mdecycu/4072pj3/project3/40723102/image/40723102.jpg

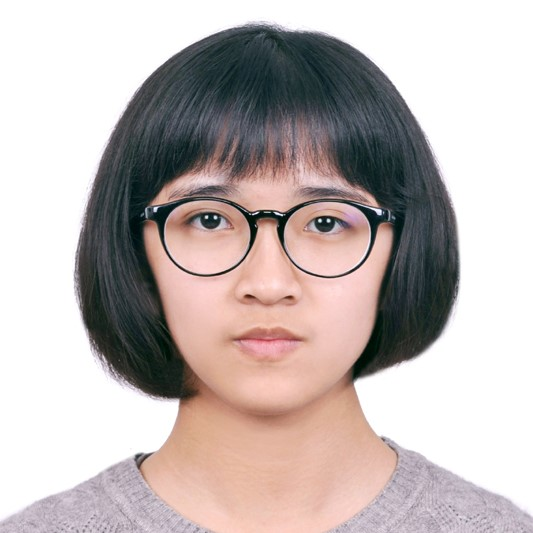
project3/40723102/image/40723102.jpg
