mdecycu/4072pj3/project3/40723102/image/40723103.jpg

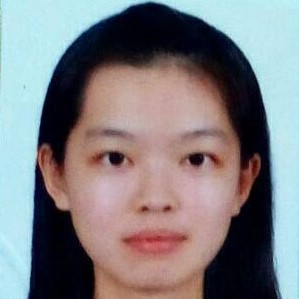
project3/40723102/image/40723103.jpg
