mdecycu/4072pj3/project3/40723102/latex/史蒂芬生機構第一型.PNG

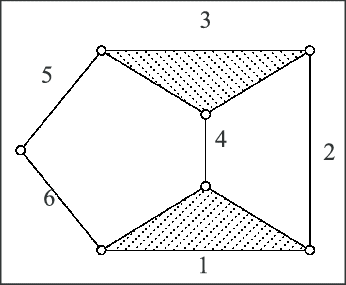
project3/40723102/latex/史蒂芬生機構第一型.PNG
