mdecycu/4072pj3/project3/40723153/架構圖S.png

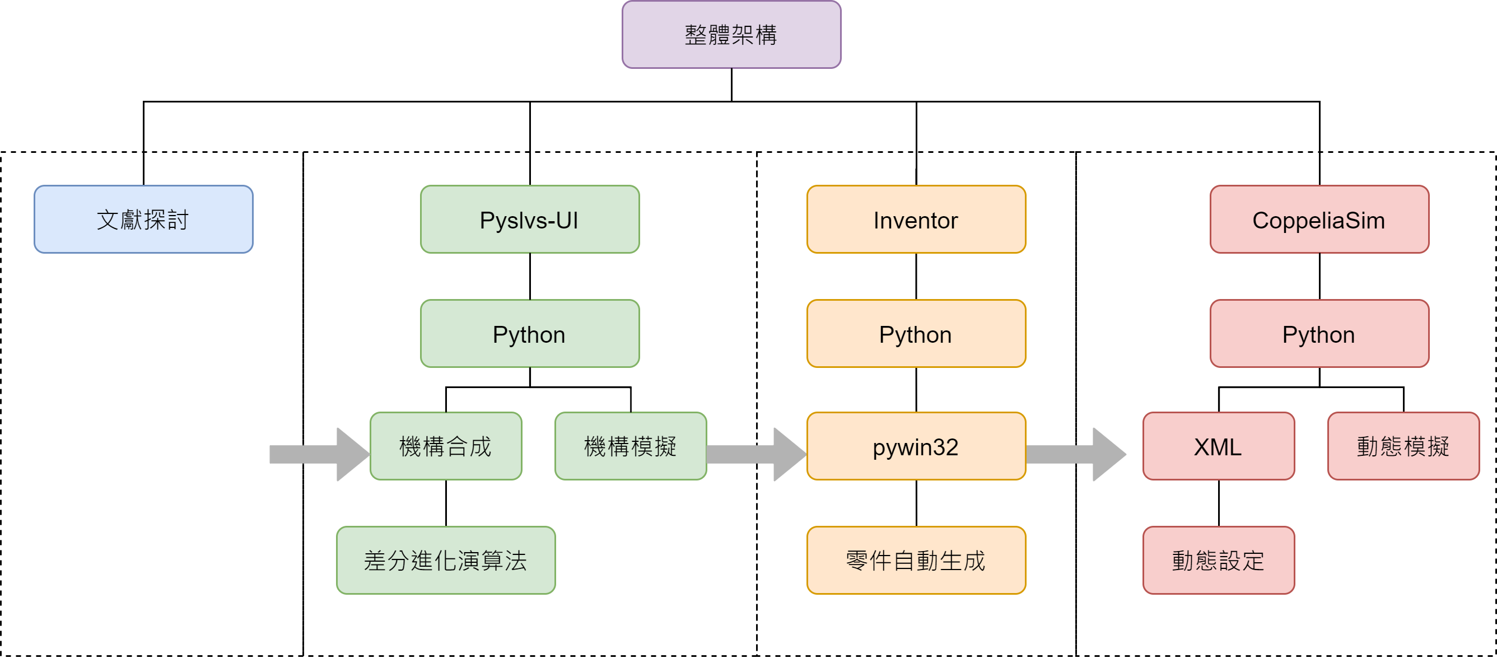
project3/40723153/架構圖S.png
