mdecycu/4072pj3/project3/latex/anti-rise_x-.png

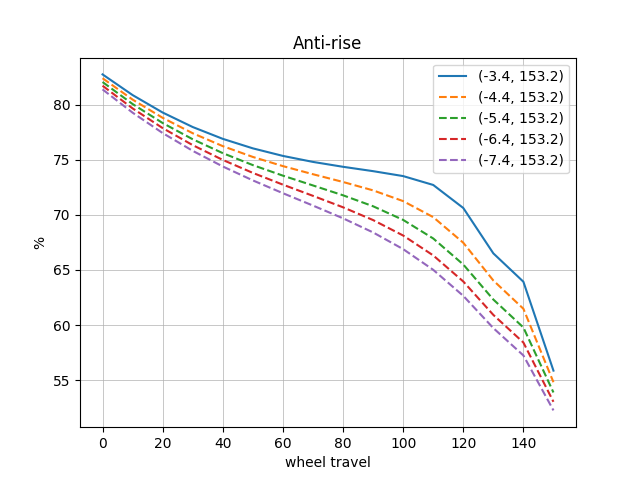
project3/latex/anti-rise_x-.png
