mdecycu/4072pj3/project3/latex/anti-squat_x-y+.png

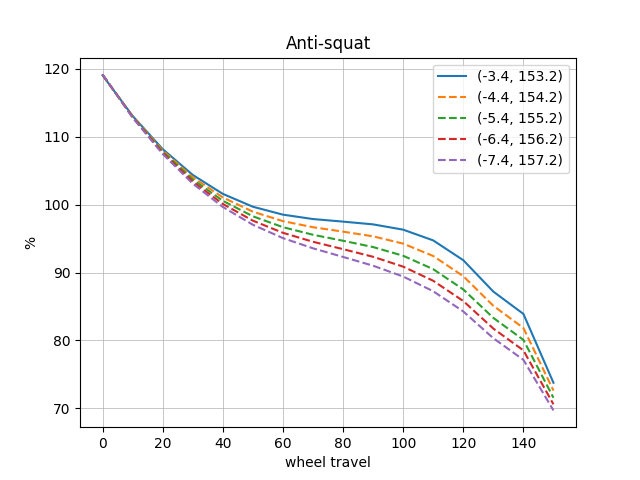
project3/latex/anti-squat_x-y+.png
