mdecycu/4072pj3/project3/latex/background2.png

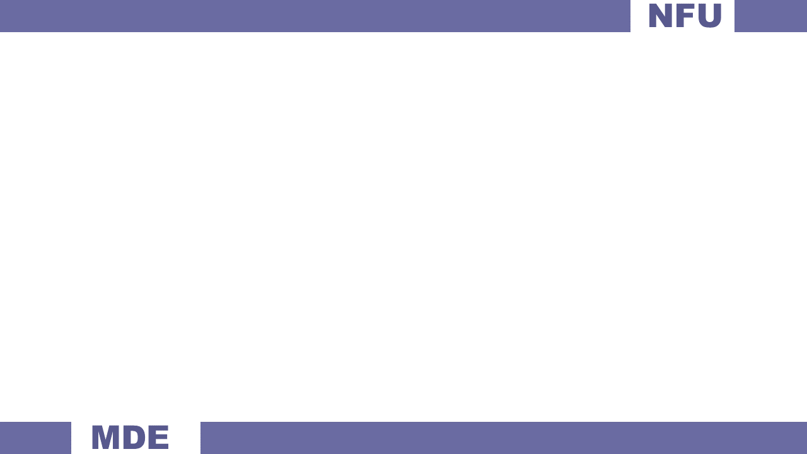
project3/latex/background2.png
