mdecycu/4072pj3/project3/latex/data/ar_p0_y+.png

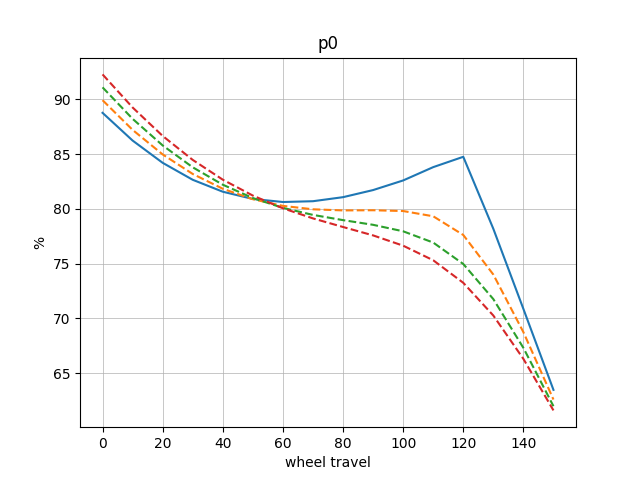
project3/latex/data/ar_p0_y+.png
