mdecycu/4072pj3/project3/latex/data/as_p0_x+.png

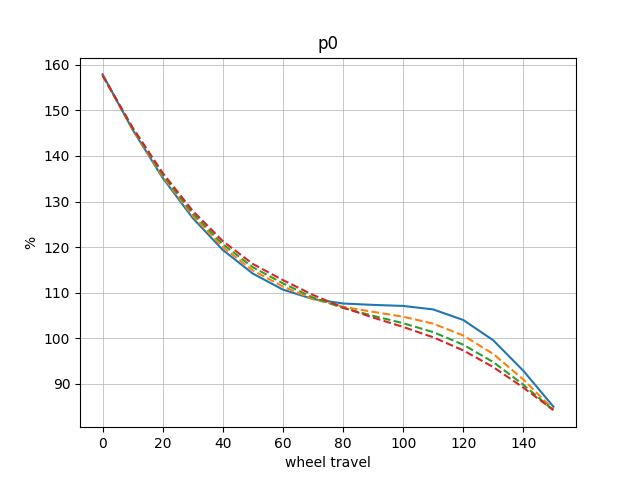
project3/latex/data/as_p0_x+.png
