mdecycu/4072pj3/project3/latex/data/as_p3_x+.png

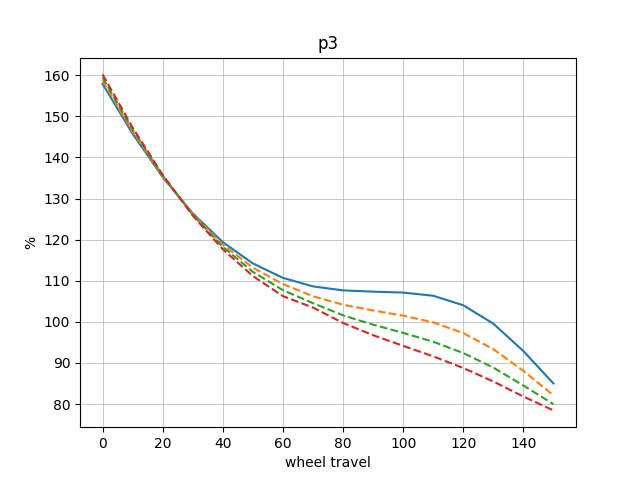
project3/latex/data/as_p3_x+.png
