mdecycu/4072pj3/project3/latex/machanism.png

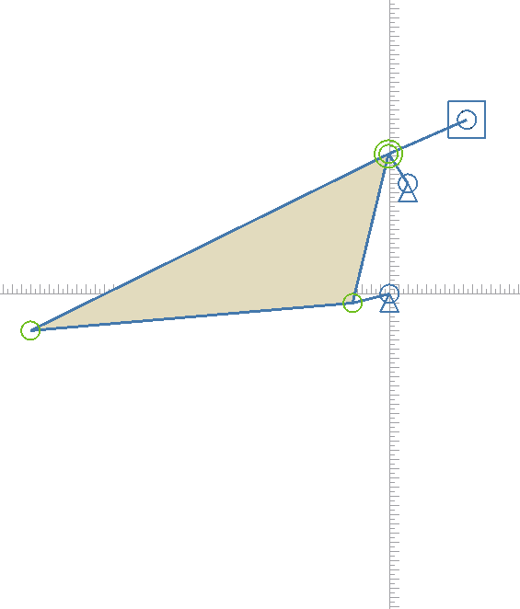
project3/latex/machanism.png
