mdecycu/4072pj3/project3/latex/wheel_travel.PNG

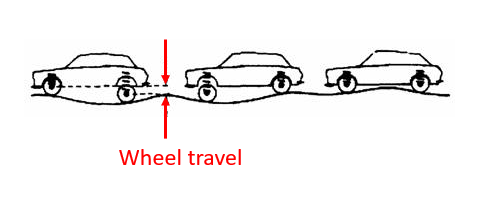
project3/latex/wheel_travel.PNG
