mdecycu/4072pj3/project3/latex/套件比較表格.jpg

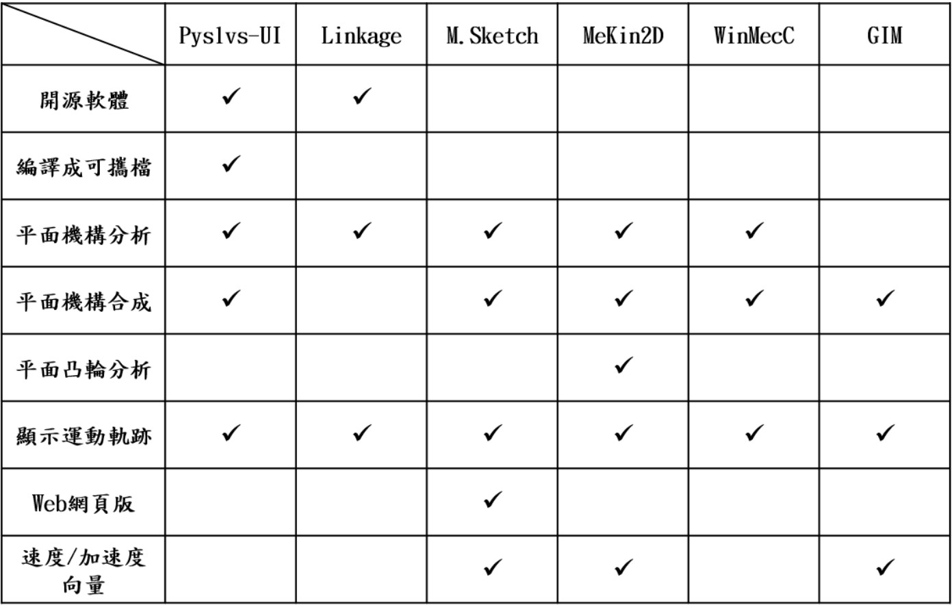
project3/latex/套件比較表格.jpg
