mdecycu/4072pj3/project3/latex/量化評比_anti_squat_x.png

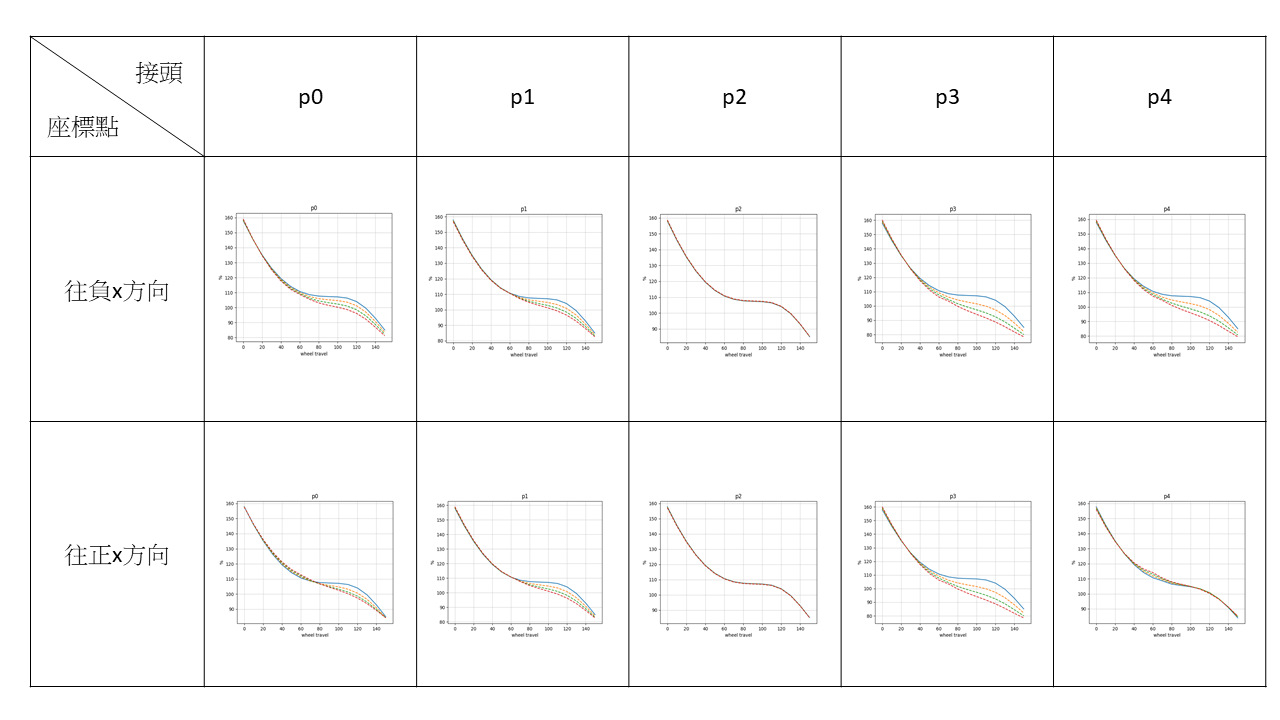
project3/latex/量化評比_anti_squat_x.png
