mdecycu/4072pj3/project3/40723245/bike_xml/Wheel.stl

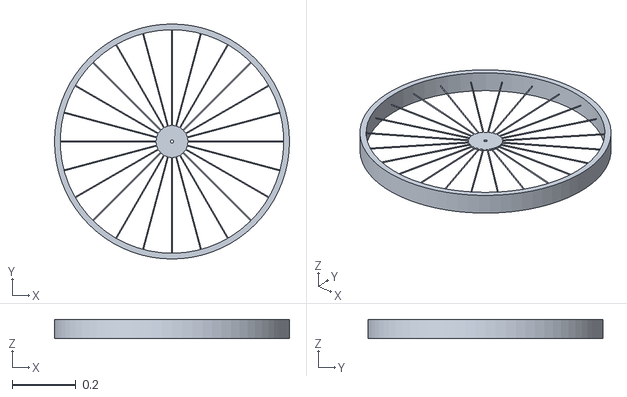
[picture p207: CAD file, 2021-05-03]
project3/40723245/bike_xml/Wheel.stl
0.736 x 0.736 x 0.06
