mdecycu/4072pj3/project3/40723245/linkage.STL

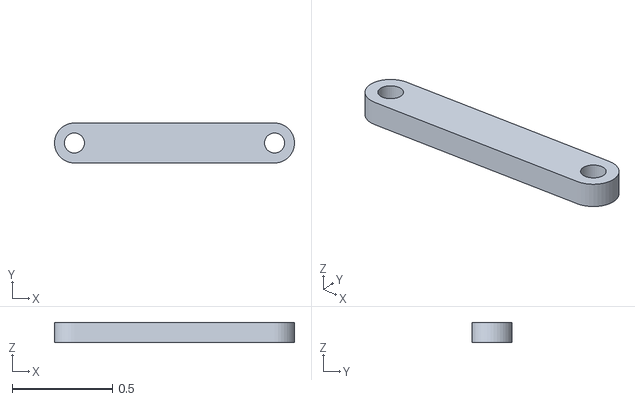
[picture p208: CAD file, 2021-03-25]
project3/40723245/linkage.STL
1.20 x 0.2 x 0.1
