mdecycu/4072pj3/project3/40723245/bike_xml/Triangle fame1.stl

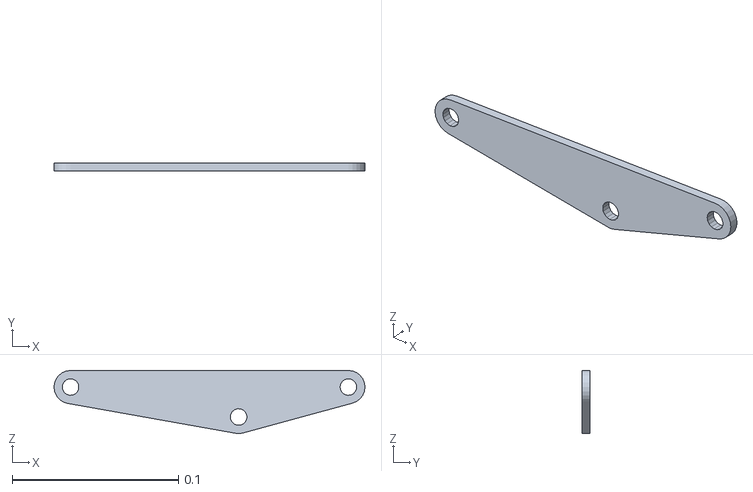
[picture p209: CAD file, 2021-05-03]
project3/40723245/bike_xml/Triangle fame1.stl
0.187 x 0.005 x 0.038
