mdecycu/4072pj3/project3/40723245/bike_xml/Fork.stl

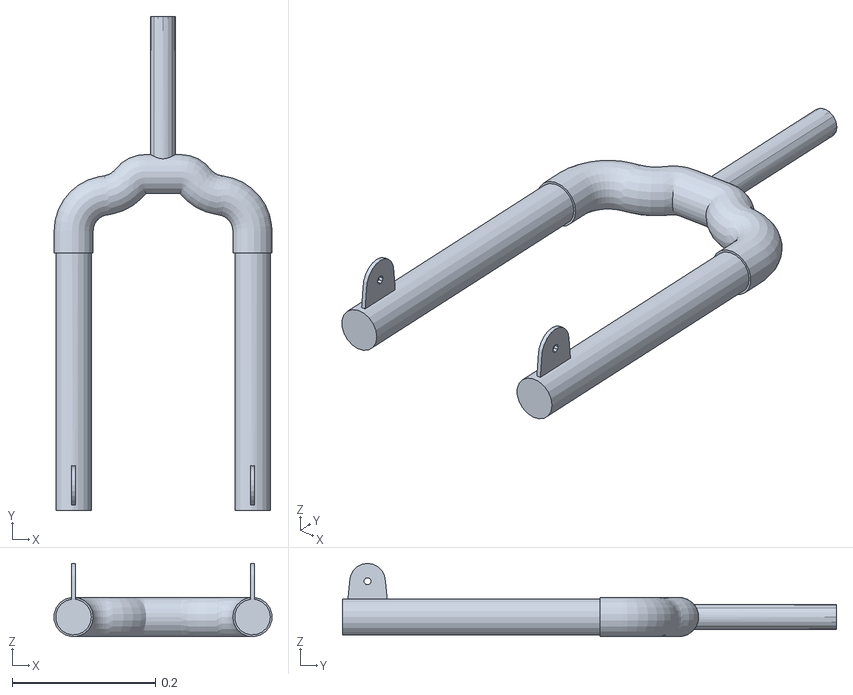
[picture p210: CAD file, 2021-05-03]
project3/40723245/bike_xml/Fork.stl
0.304 x 0.69 x 0.102
