mdecycu/4072pj3/project3/40723245/bike_xml/Slider.stl

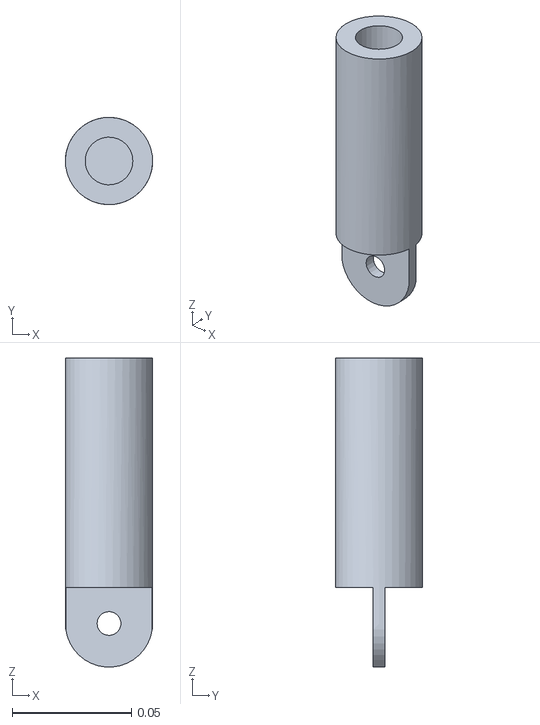
[picture p211: CAD file, 2021-05-03]
project3/40723245/bike_xml/Slider.stl
0.0365 x 0.0365 x 0.129
