mdecycu/4072pj3/project3/40723245/bike_xml/Rod.stl

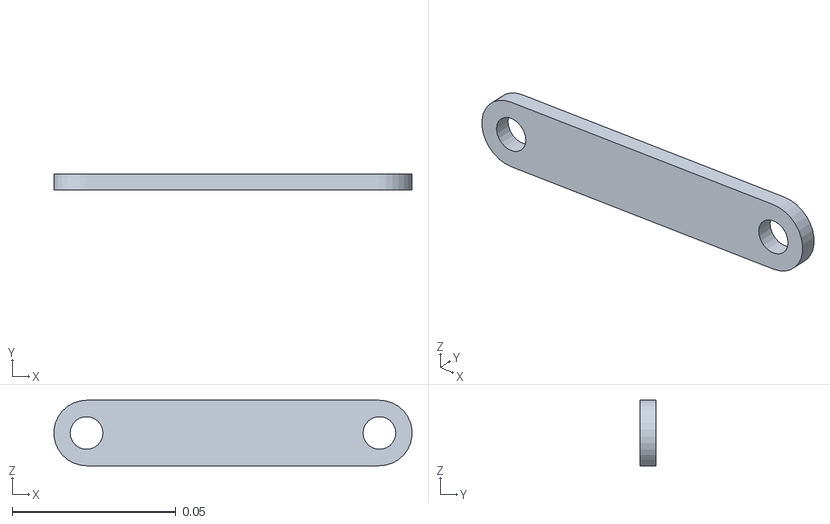
[picture p212: CAD file, 2021-05-03]
project3/40723245/bike_xml/Rod.stl
0.109 x 0.005 x 0.02
