mdecycu/4072pj3/project3/40723245/bike_xml/Triangle fame.stl

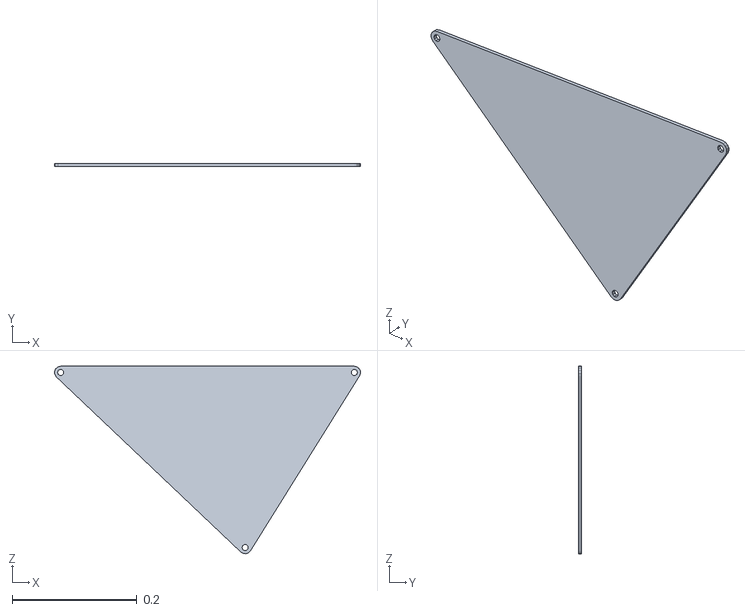
[picture p213: CAD file, 2021-05-03]
project3/40723245/bike_xml/Triangle fame.stl
0.491 x 0.005 x 0.301
