mdecycu/4072pj3/project3/40723245/bike_xml/Frame.stl

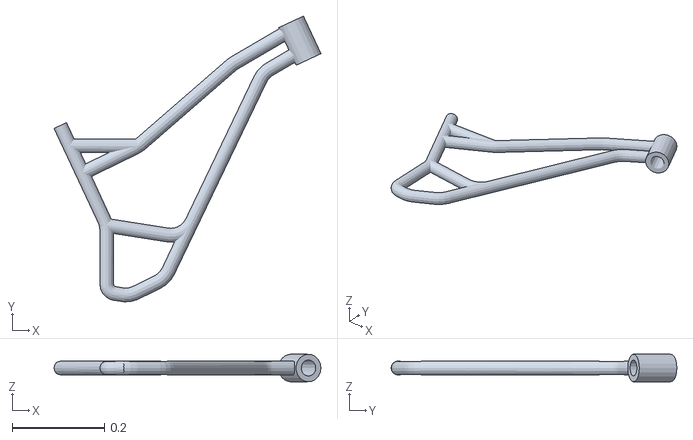
[picture p214: CAD file, 2021-05-03]
project3/40723245/bike_xml/Frame.stl
0.58 x 0.621 x 0.0598
