mdecycu/4072pj3/project3/40723245/bike_xml/Handlebar.stl

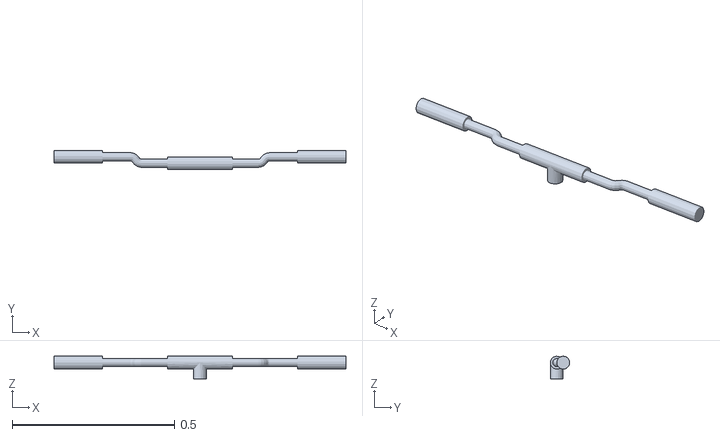
[picture p215: CAD file, 2021-05-03]
project3/40723245/bike_xml/Handlebar.stl
0.9 x 0.06 x 0.0699
