mdecycu/4072pj3/project3/40723245/bike_xml/Slider1.stl

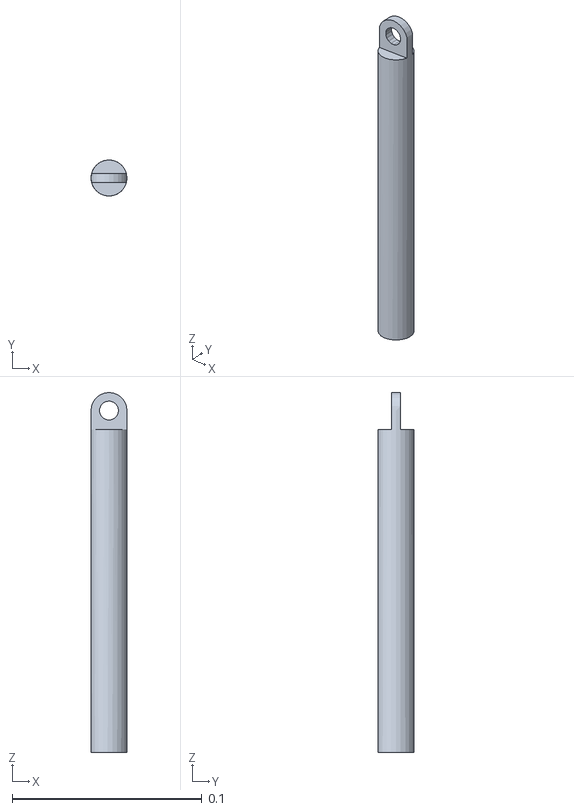
[picture p216: CAD file, 2021-05-03]
project3/40723245/bike_xml/Slider1.stl
0.019 x 0.019 x 0.19
