mdecycu/4072pj3/project3/40723245/bike_xml/pin.stl

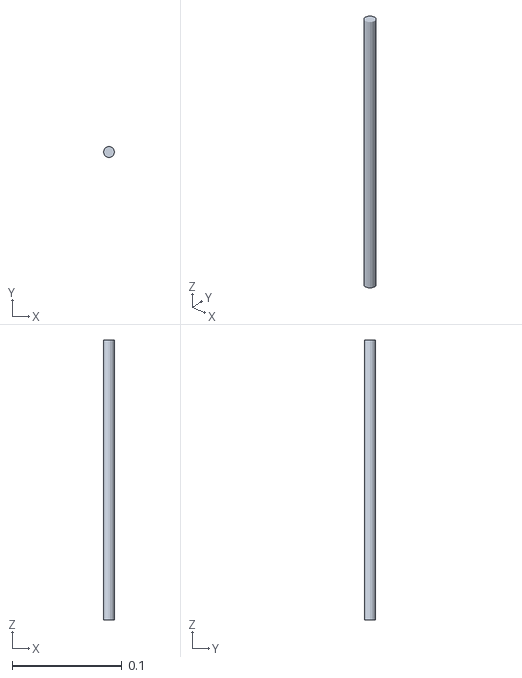
[picture p217: CAD file, 2021-05-03]
project3/40723245/bike_xml/pin.stl
0.01 x 0.00975 x 0.255
