mdecycu/4072pj3/(list of files, cad)

Other CAD files:
project3/40723103/(0317)測試連桿圖例.dwg
project3/40723102/Firebird 29 bike/Binary link.ipt
project3/40723102/Firebird 29 bike/Binary link47.ipt
project3/40723102/Firebird 29 bike/Fork.ipt
project3/40723102/Firebird 29 bike/Frame.ipt
project3/40723102/Firebird 29 bike/Handlebar.ipt
project3/40723102/Firebird 29 bike/OldVersions/Binary link.0001.ipt
project3/40723102/Firebird 29 bike/OldVersions/Binary link47.0001.ipt
project3/40723102/Firebird 29 bike/OldVersions/Fork.0033.ipt
project3/40723102/Firebird 29 bike/OldVersions/Frame.0013.ipt
project3/40723102/Firebird 29 bike/OldVersions/Handlebar.0005.ipt
project3/40723102/Firebird 29 bike/OldVersions/Slider.0008.ipt
project3/40723102/Firebird 29 bike/OldVersions/Slider1.0009.ipt
project3/40723102/Firebird 29 bike/OldVersions/Triangle link.0002.ipt
project3/40723102/Firebird 29 bike/OldVersions/Wheel.0006.ipt
project3/40723102/Firebird 29 bike/OldVersions/combination.0003.iam
project3/40723102/Firebird 29 bike/OldVersions/pin.0003.ipt
project3/40723102/Firebird 29 bike/Slider.ipt
project3/40723102/Firebird 29 bike/Slider1.ipt
project3/40723102/Firebird 29 bike/Triangle link.ipt
project3/40723102/Firebird 29 bike/Wheel.ipt
project3/40723102/Firebird 29 bike/combination.iam
project3/40723102/Firebird 29 bike/pin.ipt
project3/40723102/bike/Fork.ipt
project3/40723102/bike/Frame.ipt
project3/40723102/bike/Handlebar.ipt
project3/40723102/bike/OldVersions/combination.0007.iam
project3/40723102/bike/Rod.ipt
project3/40723102/bike/Slider.ipt
project3/40723102/bike/Slider1.ipt
project3/40723102/bike/Triangle fame.ipt
project3/40723102/bike/Triangle fame1.ipt
project3/40723102/bike/Wheel.ipt
project3/40723102/bike/combination.iam
project3/40723102/bike/pin.ipt
project3/Firebird 29 bike/Binary link.ipt
project3/Firebird 29 bike/Binary link47.ipt
project3/Firebird 29 bike/Fork.ipt
project3/Firebird 29 bike/Frame.ipt
project3/Firebird 29 bike/Handlebar.ipt
project3/Firebird 29 bike/OldVersions/Binary link.0001.ipt
project3/Firebird 29 bike/OldVersions/Binary link47.0001.ipt
project3/Firebird 29 bike/OldVersions/Fork.0033.ipt
project3/Firebird 29 bike/OldVersions/Frame.0013.ipt
project3/Firebird 29 bike/OldVersions/Handlebar.0005.ipt
project3/Firebird 29 bike/OldVersions/Slider.0008.ipt
project3/Firebird 29 bike/OldVersions/Slider1.0009.ipt
project3/Firebird 29 bike/OldVersions/Triangle link.0002.ipt
project3/Firebird 29 bike/OldVersions/Wheel.0006.ipt
project3/Firebird 29 bike/OldVersions/combination.0003.iam
project3/Firebird 29 bike/OldVersions/pin.0003.ipt
project3/Firebird 29 bike/Slider.ipt
project3/Firebird 29 bike/Slider1.ipt
project3/Firebird 29 bike/Triangle link.ipt
project3/Firebird 29 bike/Wheel.ipt
project3/Firebird 29 bike/combination.iam
project3/Firebird 29 bike/pin.ipt
project3/bike/Fork.ipt
project3/bike/Frame.ipt
project3/bike/Handlebar.ipt
project3/bike/OldVersions/Slider.0007.ipt
project3/bike/OldVersions/combination.0007.iam
project3/bike/Rod.ipt
project3/bike/Slider.ipt
project3/bike/Slider1.ipt
project3/bike/Triangle fame.ipt
project3/bike/Triangle fame1.ipt
project3/bike/Wheel.ipt
project3/bike/binary_link.ipt
project3/bike/combination.iam
project3/bike/pin.ipt
project3/bike/ternary_link.ipt
