mdecycu/4072pj3/project3/latex/synthesis_result_bike.png

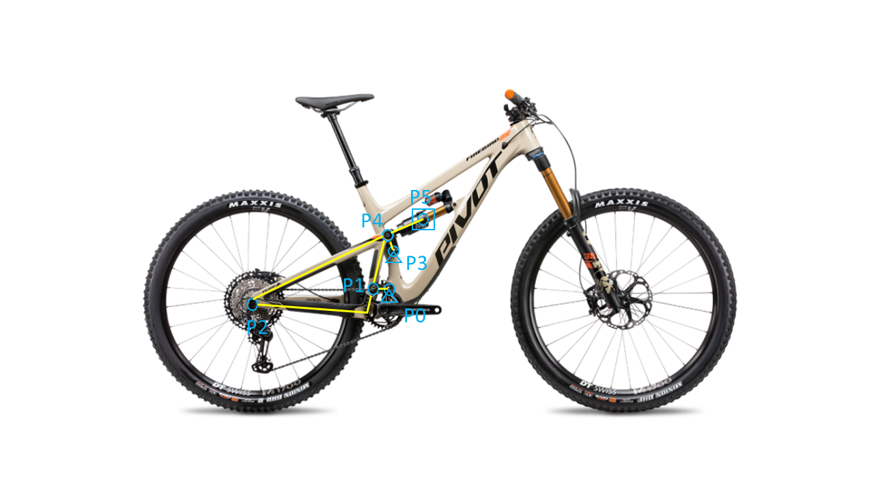
project3/latex/synthesis_result_bike.png
