mdecycu/4072pj3/(commit log)

2021-03-25 move data from pyslvs
    [(0317)測試連桿圖例.dwg, binary_link.ipt, linkage.STL, ternary_link.ipt]
2021-04-09 add bike folder
    [0331.0002.ipt, Fork.ipt, Frame.ipt, Handlebar.ipt, Rod.0001.ipt, Rod.ipt, Slider.ipt, Slider1.ipt]
2021-04-09 update bike folder
    [0331.0002.ipt, Rod.0001.ipt, bick1.0015.ipt, combination.0006.iam, combination.0007.iam, combination.iam, combination2.0001.iam, test.0001.ipt]
2021-04-09 add slide in link_gen.py
    [Fork.ipt, Frame.ipt, Handlebar.ipt, Rod.ipt, Slider.0007.ipt, Slider.ipt, Slider1.ipt, Triangle fame.ipt]
2021-04-28 update latex-平面機構合成套件
2021-04-29 add bike_stl
    [Fork.stl, Frame.stl, Handlebar.stl, Rod.stl, Slider.stl, Slider1.stl, Triangle fame.stl, Triangle fame1.stl]
2021-05-01 add bike_xml folder
    [Fork.stl, Frame.stl, Handlebar.stl, Rod.stl, Slider.stl, Slider1.stl, Triangle fame.stl, Triangle fame1.stl]
2021-05-03 update latex-平面機構分析套件
2021-05-13 update 流程圖
2021-05-20 add 套件比較表格.png
2021-05-20 modify 套件比較表
2021-05-21 update reveal-平面多連桿機構套件比較
2021-05-21 add Firebird 29 bike
    [Binary link.0001.ipt, Binary link.ipt, Binary link47.0001.ipt, Binary link47.ipt, Fork.0033.ipt, Fork.ipt, Frame.0013.ipt, Frame.ipt]
2021-05-27 update 平面多連桿機構套件比較
2021-06-01 update reveal-套件比較表
2021-06-06 update架構圖
2021-06-08 upload 研究動機
2021-06-14 update latex-摘要行距
